Greed2003/controle-metassuperficie/docs/hardware/esquematico_completo.png

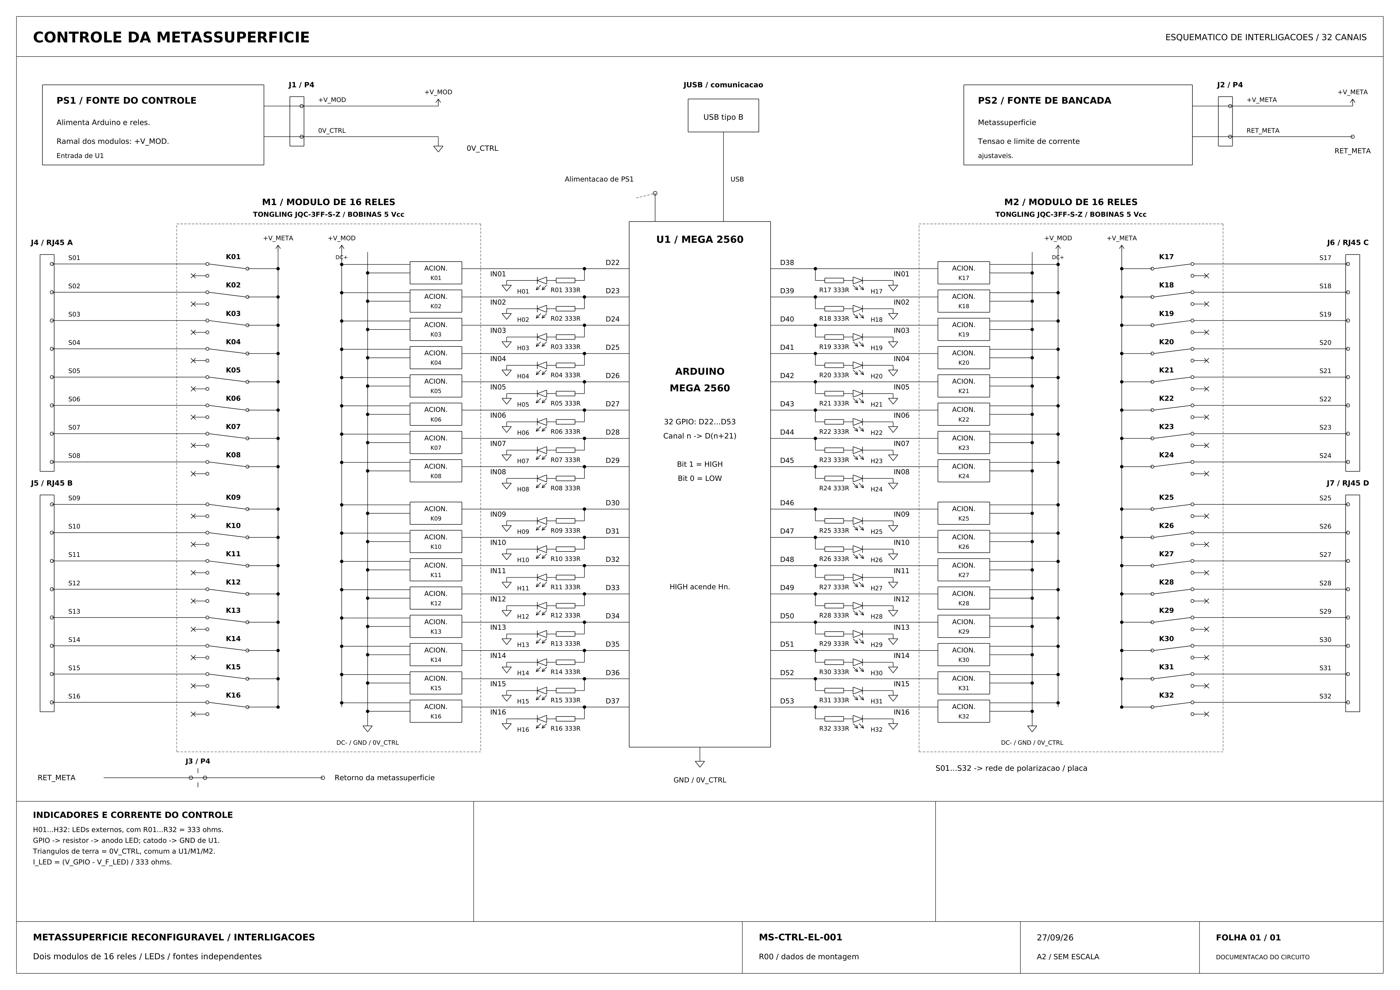
docs/hardware/esquematico_completo.png
