Greed2003/controle-metassuperficie/docs/hardware/sistema_controle_artigo.png

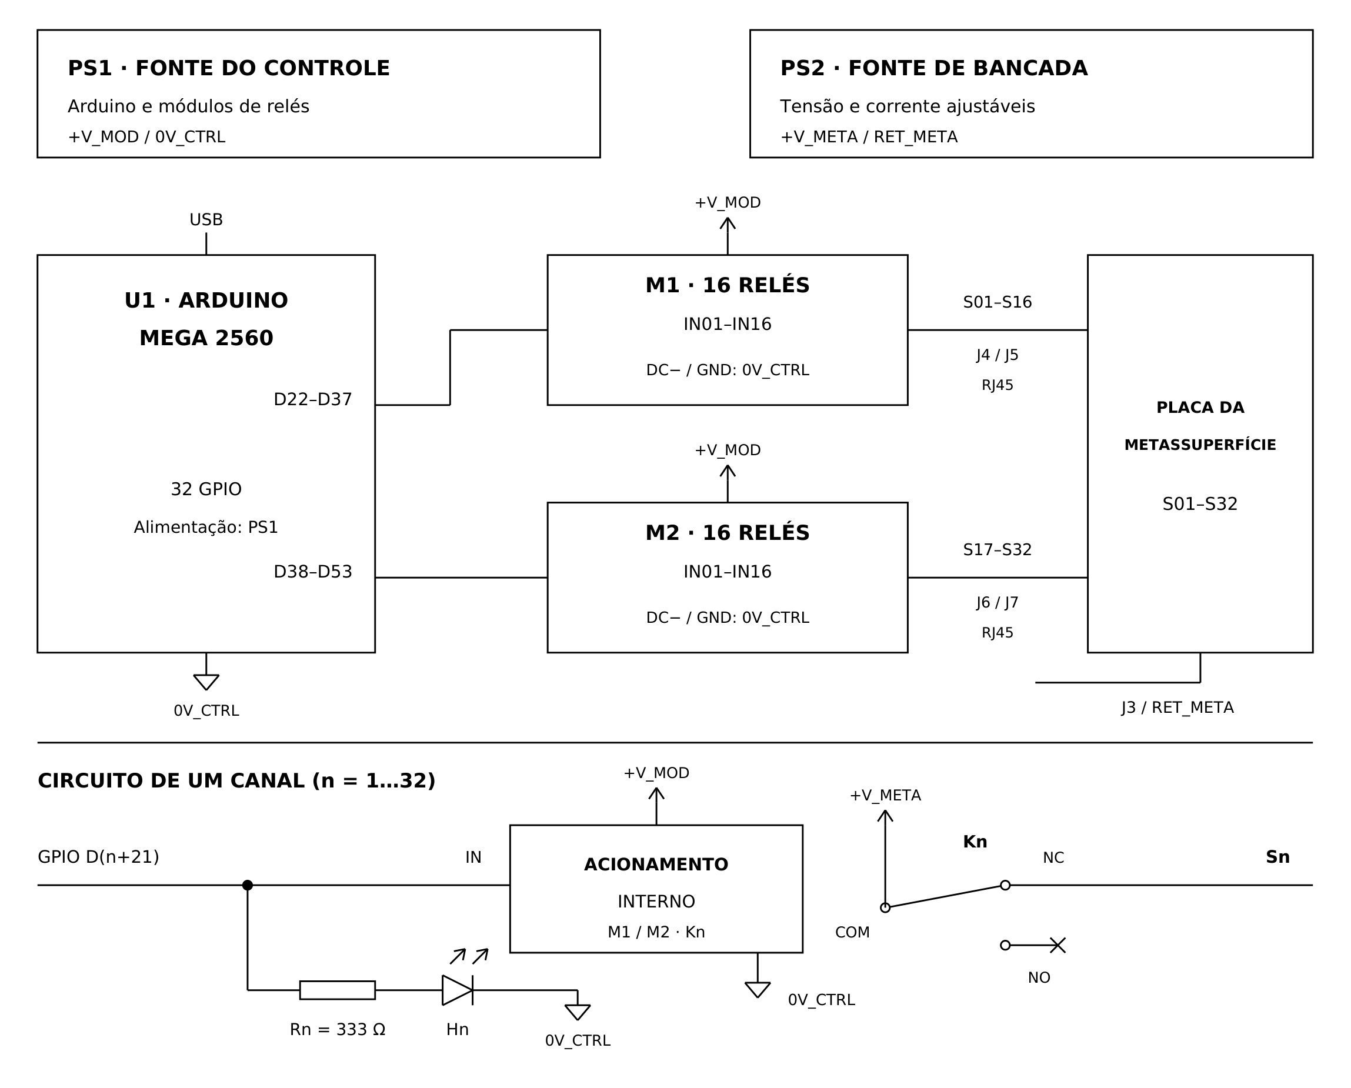
docs/hardware/sistema_controle_artigo.png
