Greed2003/controle-metassuperficie/(list of files, cad)

Other CAD files:
docs/hardware/esquematico_completo.dxf
