Greed2003/controle-metassuperficie/docs/hardware/esquematico_completo.pdf

### PS1 / FONTE DO CONTROLE

### PS2 / FONTE DE BANCADA

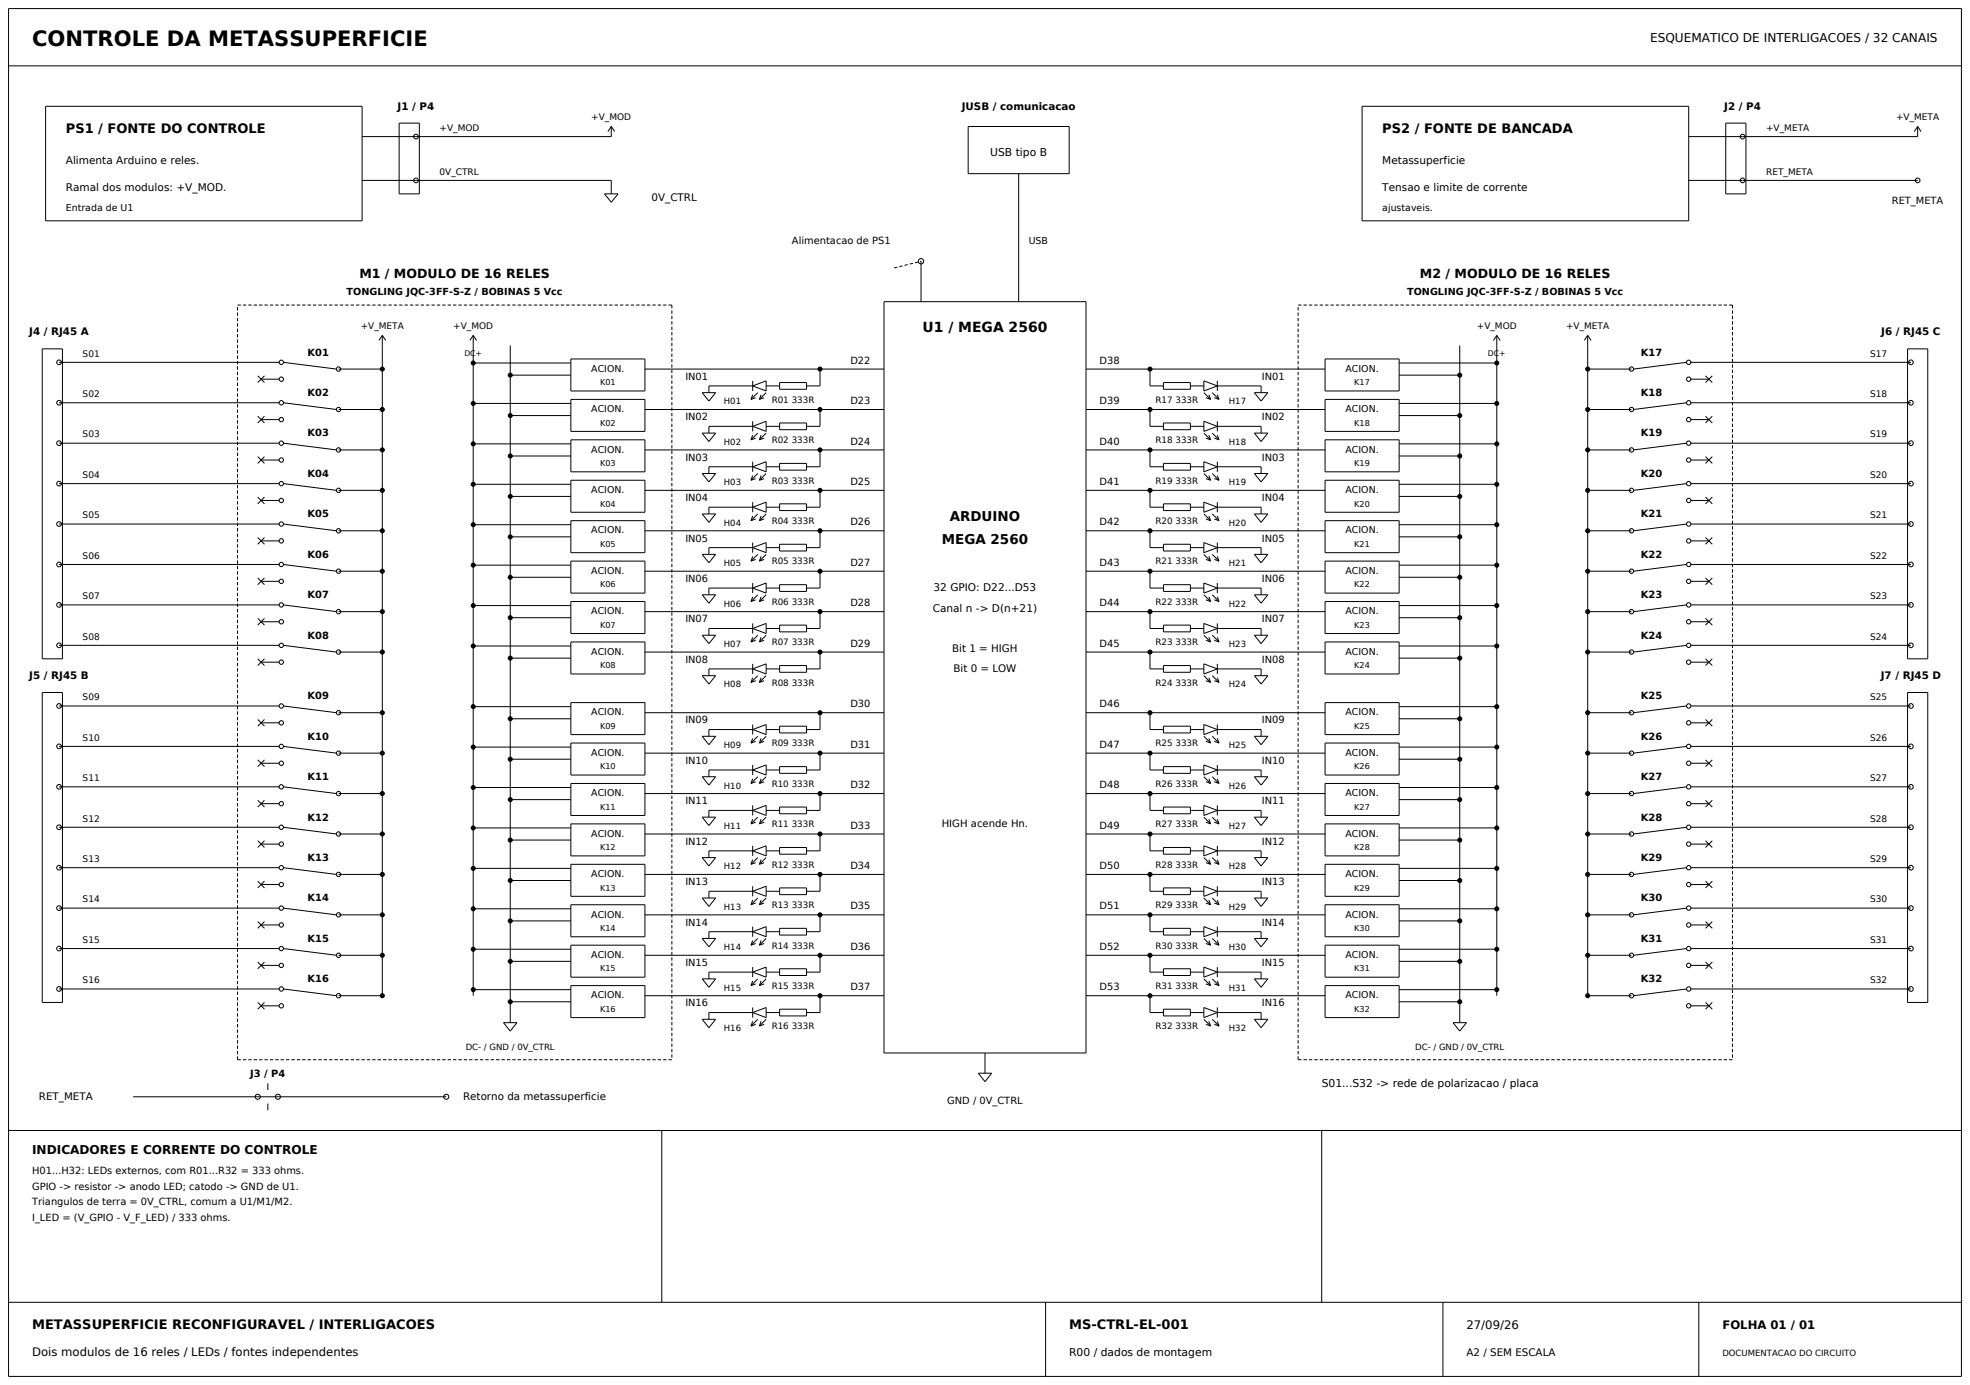
[picture p3: page 1]

Tensao e limite de corrente

TONGLING JQC-3FF-S-Z / BOBINAS 5 Vcc

S01...S32 -> rede de polarizacao / placa

INDICADORES E CORRENTE DO CONTROLE H01...H32: LEDs externos, com R01...R32 = 333 ohms. GPIO -> resistor -> anodo LED; catodo -> GND de U1. Triangulos de terra = 0V_CTRL, comum a U1/M1/M2. I_LED = (V_GPIO - V_F_LED) / 333 ohms.

METASSUPERFICIE RECONFIGURAVEL / INTERLIGACOES Dois modulos de 16 reles / LEDs / fontes independentes | MS-CTRL-EL-001 R00 / dados de montagem | 27/09/26 A2 / SEM ESCALA | FOLHA 01 / 01 DOCUMENTACAO DO CIRCUITO
