Greed2003/controle-metassuperficie/src/pattern_catalog.cpp

#include "metasurface/pattern_catalog.hpp"
#include "metasurface/mode.hpp"

#if defined(__AVR__)
#include <avr/pgmspace.h>
#endif

namespace metasurface {
namespace {

constexpr int kMaxPatterns = 12;

// Bit 0 corresponds to channel 1.
const uint32_t kPatterns[kMaxChannels][kMaxPatterns]
#if defined(__AVR__)
    PROGMEM
#endif
    = {
    {0x00000000u, 0x00000001u}, // M1
    {0x00000000u, 0x00000002u, 0x00000001u, 0x00000003u}, // M2
    {0x00000000u, 0x00000004u, 0x00000002u, 0x00000006u, 0x00000001u, 0x00000005u, // M3
     0x00000003u, 0x00000007u},
    {0x00000000u, 0x0000000fu, 0x00000005u, 0x0000000au, 0x00000003u, 0x0000000cu, // M4
     0x00000009u, 0x00000006u, 0x00000001u, 0x00000002u, 0x00000004u, 0x00000008u},
    {0x00000000u, 0x0000001fu, 0x00000015u, 0x0000000au, 0x00000013u, 0x0000000cu, // M5
     0x0000000fu, 0x00000010u, 0x00000011u, 0x00000004u, 0x00000007u, 0x00000018u},
    {0x00000000u, 0x0000003fu, 0x00000015u, 0x0000002au, 0x00000033u, 0x0000000cu, // M6
     0x0000000fu, 0x00000030u, 0x00000021u, 0x00000007u, 0x00000038u, 0x00000001u},
    {0x00000000u, 0x0000007fu, 0x00000055u, 0x0000002au, 0x00000033u, 0x0000004cu, // M7
     0x0000000fu, 0x00000070u, 0x00000041u, 0x00000008u, 0x00000001u, 0x00000002u},
    {0x00000000u, 0x000000ffu, 0x00000055u, 0x000000aau, 0x00000033u, 0x000000ccu, // M8
     0x0000000fu, 0x000000f0u, 0x00000081u, 0x00000018u, 0x00000001u, 0x00000002u},
    {0x00000000u, 0x000001ffu, 0x00000155u, 0x000000aau, 0x00000133u, 0x000000ccu, // M9
     0x0000010fu, 0x000000f0u, 0x00000101u, 0x00000010u, 0x0000001fu, 0x000001e0u},
    {0x00000000u, 0x000003ffu, 0x00000155u, 0x000002aau, 0x00000333u, 0x000000ccu, // M10
     0x0000030fu, 0x000000f0u, 0x00000201u, 0x00000030u, 0x0000001fu, 0x000003e0u},
    {0x00000000u, 0x000007ffu, 0x00000555u, 0x000002aau, 0x00000333u, 0x000004ccu, // M11
     0x0000070fu, 0x000000f0u, 0x00000401u, 0x00000020u, 0x0000003fu, 0x000007c0u},
    {0x00000000u, 0x00000fffu, 0x00000555u, 0x00000aaau, 0x00000333u, 0x00000cccu, // M12
     0x00000f0fu, 0x000000f0u, 0x00000801u, 0x00000060u, 0x0000003fu, 0x00000fc0u},
    {0x00000000u, 0x00001fffu, 0x00001555u, 0x00000aaau, 0x00001333u, 0x00000cccu, // M13
     0x00000f0fu, 0x000010f0u, 0x00001001u, 0x00000040u, 0x0000007fu, 0x00001f80u},
    {0x00000000u, 0x00003fffu, 0x00001555u, 0x00002aaau, 0x00003333u, 0x00000cccu, // M14
     0x00000f0fu, 0x000030f0u, 0x00002001u, 0x000000c0u, 0x0000007fu, 0x00003f80u},
    {0x00000000u, 0x00007fffu, 0x00005555u, 0x00002aaau, 0x00003333u, 0x00004cccu, // M15
     0x00000f0fu, 0x000070f0u, 0x00004001u, 0x00000080u, 0x000000ffu, 0x00007f00u},
    {0x00000000u, 0x0000ffffu, 0x00005555u, 0x0000aaaau, 0x00003333u, 0x0000ccccu, // M16
     0x00000f0fu, 0x0000f0f0u, 0x00008001u, 0x00000180u, 0x000000ffu, 0x0000ff00u},
    {0x00000000u, 0x0001ffffu, 0x00015555u, 0x0000aaaau, 0x00013333u, 0x0000ccccu, // M17
     0x00010f0fu, 0x0000f0f0u, 0x00010001u, 0x00000100u, 0x000001ffu, 0x0001fe00u},
    {0x00000000u, 0x0003ffffu, 0x00015555u, 0x0002aaaau, 0x00033333u, 0x0000ccccu, // M18
     0x00030f0fu, 0x0000f0f0u, 0x00020001u, 0x00000300u, 0x000001ffu, 0x0003fe00u},
    {0x00000000u, 0x0007ffffu, 0x00055555u, 0x0002aaaau, 0x00033333u, 0x0004ccccu, // M19
     0x00070f0fu, 0x0000f0f0u, 0x00040001u, 0x00000200u, 0x000003ffu, 0x0007fc00u},
    {0x00000000u, 0x000fffffu, 0x00055555u, 0x000aaaaau, 0x00033333u, 0x000cccccu, // M20
     0x000f0f0fu, 0x0000f0f0u, 0x00080001u, 0x00000600u, 0x000003ffu, 0x000ffc00u},
    {0x00000000u, 0x001fffffu, 0x00155555u, 0x000aaaaau, 0x00133333u, 0x000cccccu, // M21
     0x000f0f0fu, 0x0010f0f0u, 0x00100001u, 0x00000400u, 0x000007ffu, 0x001ff800u},
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
};

}

int pattern_count(int mode) {
    if (!is_valid_mode(mode)) {
        return 0;
    }
    return mode < 4 ? (1 << mode) : kMaxPatterns;
}

bool get_pattern(int mode, int table, uint32_t& outputs) {
    if (table < 1 || table > pattern_count(mode)) {
        return false;
    }
#if defined(__AVR__)
    outputs = pgm_read_dword(&kPatterns[mode - 1][table - 1]);
#else
    outputs = kPatterns[mode - 1][table - 1];
#endif
    return true;
}

}
