Greed2003/controle-metassuperficie/(commit log)

2026-10-26 feat: valida modos de operacao de 1 a 32
2026-11-01 ci: configura Jenkins com agente C++ e pipeline de testes
2026-11-02 feat: interpreta comandos de selecao de modo
2026-11-02 feat: unifica processamento de comandos
2026-11-02 feat: adiciona catalogo de padroes
2026-11-02 build: adiciona compilacao AVR para ATmega2560
2026-11-02 perf: armazena catalogo de padroes na Flash
2026-11-02 feat: adiciona camada de controle das saidas
2026-11-02 feat: adiciona GPIO para ATmega2560
2026-11-02 feat: adiciona UART para ATmega2560
2026-11-02 feat: gera firmware ELF e HEX para ATmega2560
2026-11-02 docs: adiciona esquematicos e documentacao do circuito
    [esquematico_completo.dxf]
